julbouln/musicbox/README

Deprecated, see https://github.com/julbouln/musicboxV2
