julbouln/musicbox/hardware/musicbox-interface.brd

## EAGLE design hardware/musicbox-interface.brd (2015-06-21)

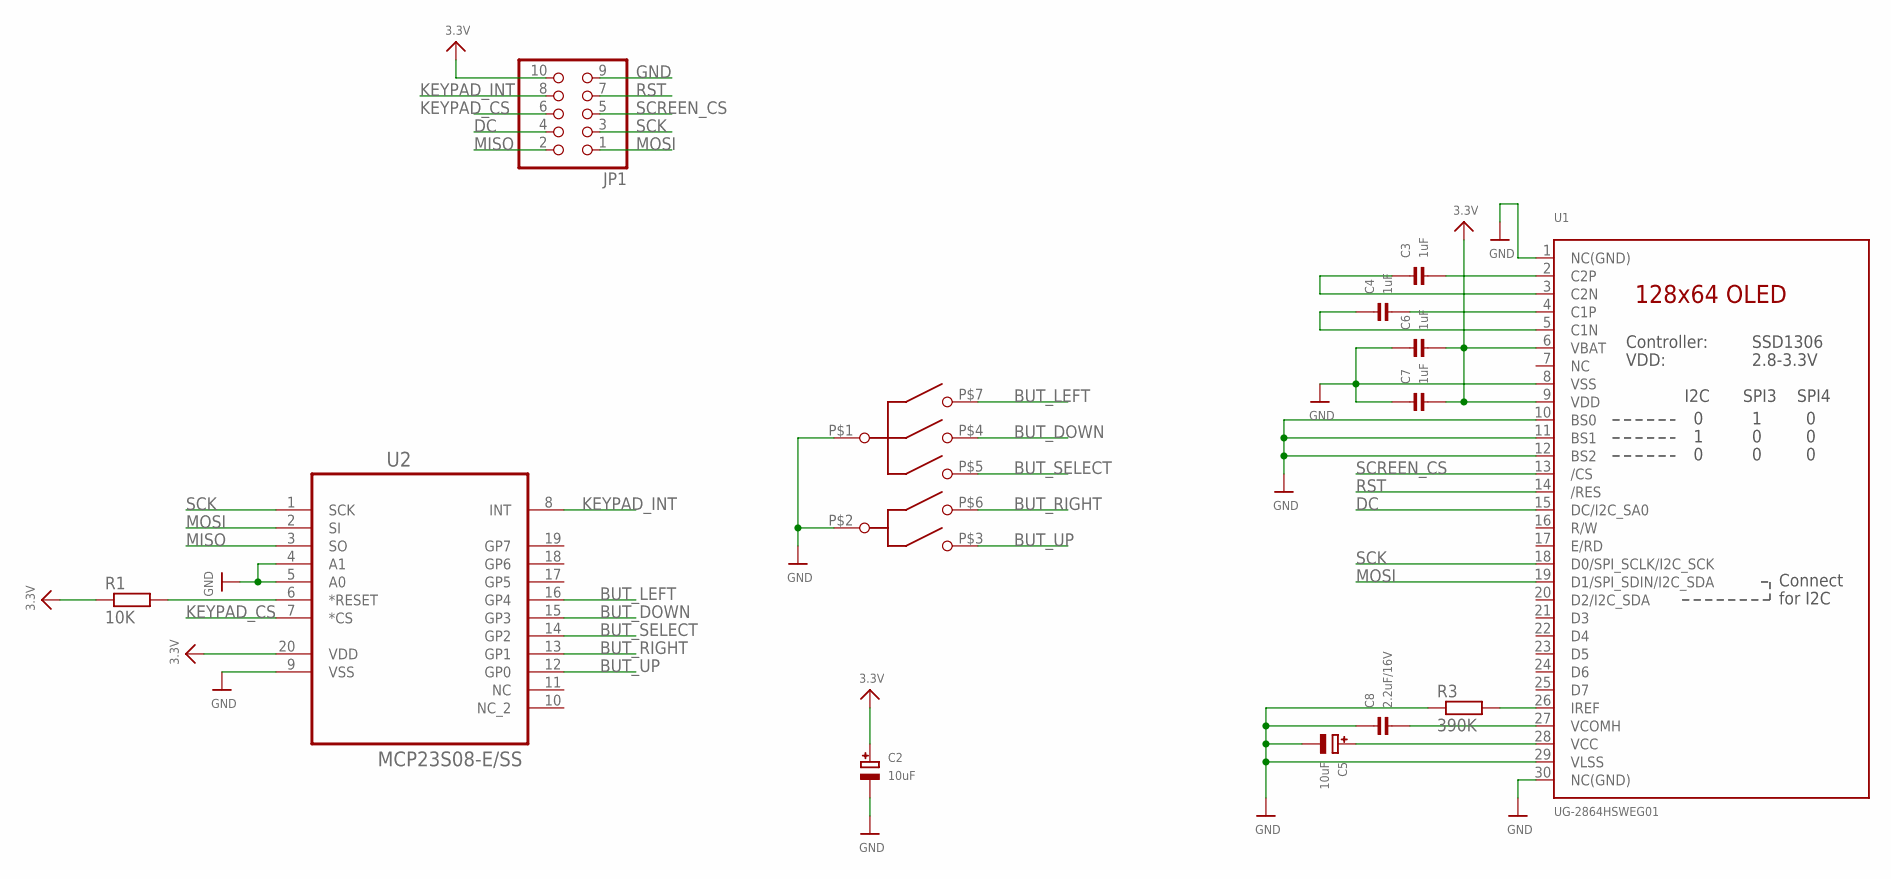
[picture p1: schematic musicbox-interface.sch]

Parts:
C2, C5: 10uF; EIA3216-18/A-R
C3, C4, C6, C7: 1uF; 0603
C8: 2.2uF/16V; 0603
JP1: HEADER-2X5; 2X05
R1: 10K; R0603
R3: 390K; R0603
U1: UG-2864HSWEG01; UG-2864HSWEG01_0.96IN_WRAPAROUND
U2: MCP23S08-E/SS; SOP65P780X200-20N
U$5: TPA; SMT

Connections:
3.3V: C2.+, C6.2, C7.2, JP1.10, R1.1, U1.6 (VBAT), U1.9 (VDD), U2.20 (VDD)
BUT_DOWN: U2.15 (GP3), U$5.P$4 (DOWN)
BUT_LEFT: U2.16 (GP4), U$5.P$7 (LEFT)
BUT_RIGHT: U2.13 (GP1), U$5.P$6 (RIGHT)
BUT_SELECT: U2.14 (GP2), U$5.P$5 (SELECT)
BUT_UP: U2.12 (GP0), U$5.P$3 (UP)
DC: JP1.4, U1.15 (DC/I2C_SA0)
GND: C2.-, C5.-, C6.1, C7.1, C8.1, JP1.9, R3.1, U1.1 (NC(GND)), U1.8 (VSS), U1.10 (BS0), U1.11 (BS1), U1.12 (BS2), U1.29 (VLSS), U1.30 (NC(GND)), U2.4 (A1), U2.5 (A0), U2.9 (VSS), U$5.P$1 (COMMON_1), U$5.P$2 (COMMON_2)
KEYPAD_CS: JP1.6, U2.7 (*CS)
KEYPAD_INT: JP1.8, U2.8 (INT)
MISO: JP1.2, U2.3 (SO)
MOSI: JP1.1, U1.19 (D1/SPI_SDIN/I2C_SDA), U2.2 (SI)
unnamed: C5.+, U1.28 (VCC)
unnamed: R1.2, U2.6 (*RESET)
unnamed: R3.2, U1.26 (IREF)
unnamed: C3.2, U1.2 (C2P)
unnamed: C3.1, U1.3 (C2N)
unnamed: C4.2, U1.4 (C1P)
unnamed: C4.1, U1.5 (C1N)
unnamed: C8.2, U1.27 (VCOMH)
RST: JP1.7, U1.14 (/RES)
SCK: JP1.3, U1.18 (D0/SPI_SCLK/I2C_SCK), U2.1 (SCK)
SCREEN_CS: JP1.5, U1.13 (/CS)

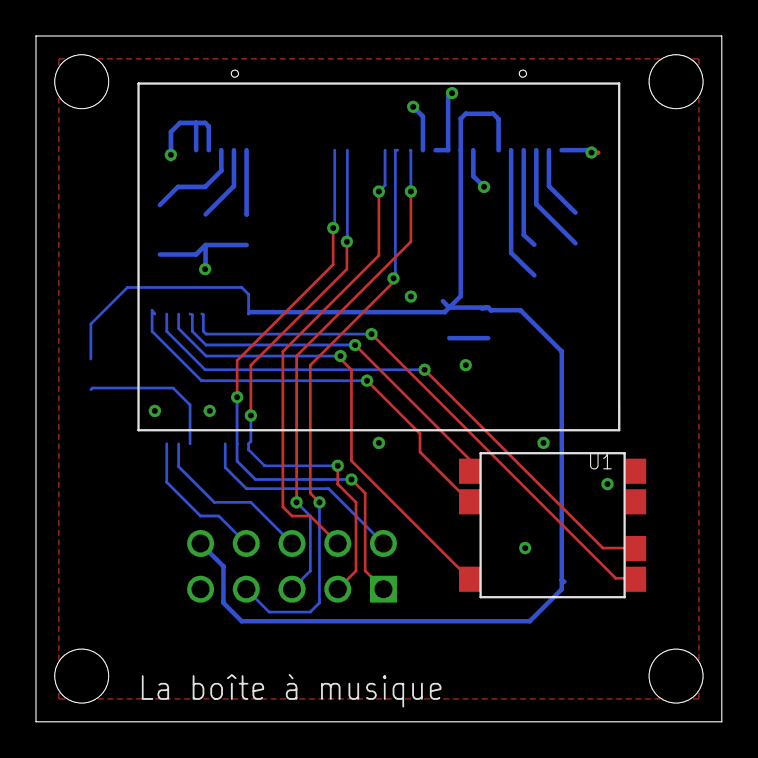
[picture p2: board musicbox-interface.brd from above]

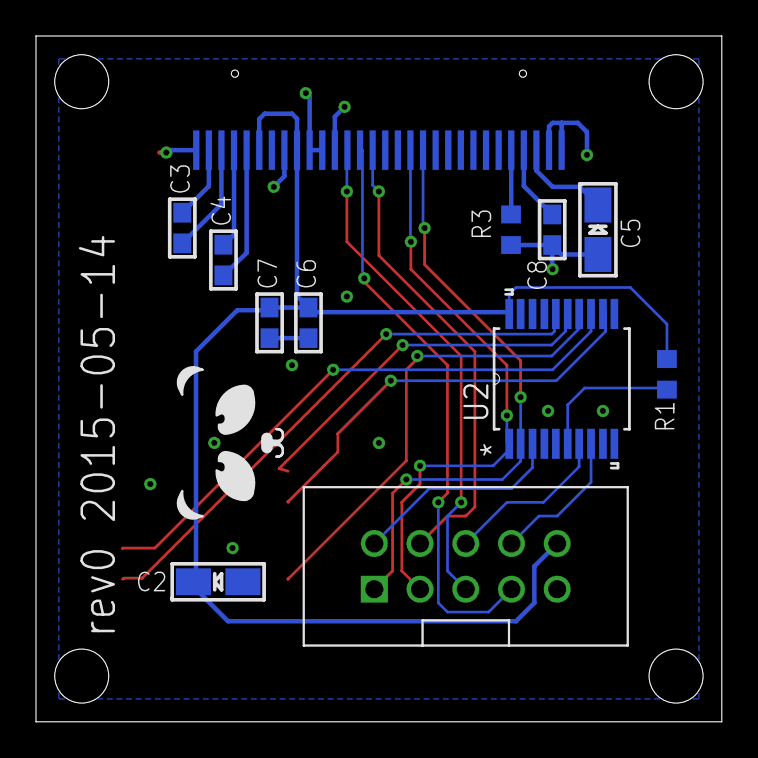
[picture p3: board musicbox-interface.brd from below]

Board: 2 copper layers, 38.1 x 38.1 mm, 14 parts (12 on the bottom side), 23 nets.

Other parts of the board:
U$8: PANDA
